ma-loco/BasicSAMDArduino/BasicCustomBoard-Hardware/BasicCustomBoardExample.jpg

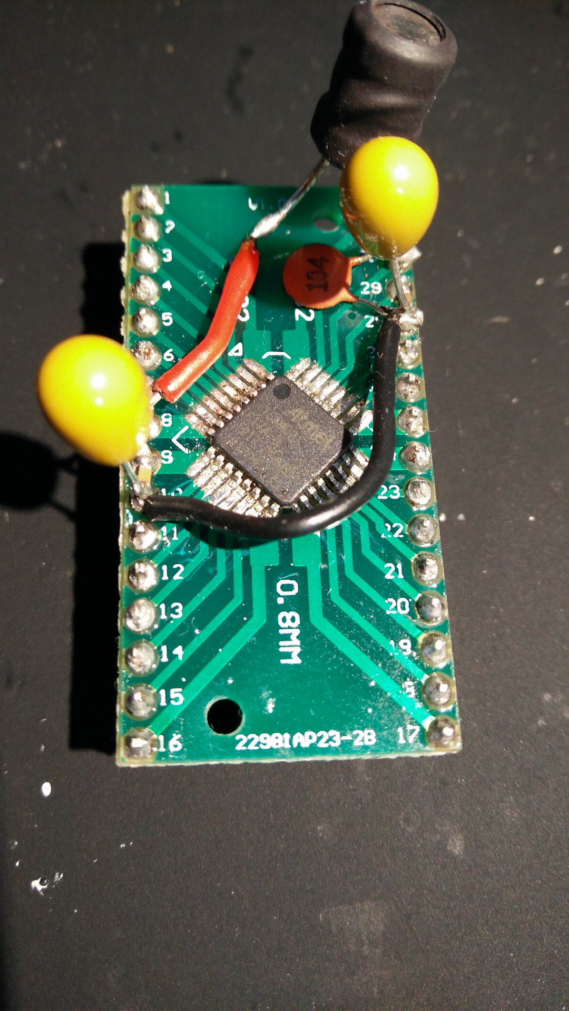
BasicCustomBoard-Hardware/BasicCustomBoardExample.jpg
