ma-loco/BasicSAMDArduino/BasicCustomBoard-Hardware/BasicCustomBoard.kicad_pcb

## KiCad design Report/electricals/electricals.sch


Parts:
ForceSensor: R
R3.3K: R
SW: SW_Push

Connections:
+5V: ForceSensor.1, SW.1
Earth: R3.3K.2
unnamed: ForceSensor.2, R3.3K.1

Notes on the sheet:
Force Sensor Circuit
Button Circuit
Arduino Direction
Arduino PWM
Arduino Button Read
Arduino Force Sensor Read
Motor Circuit
