ma-loco/BasicSAMDArduino/variants/generic_samd21e16b/variant.h

/*
  Copyright (c) 2014-2015 Arduino LLC.  All right reserved.

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
  You should have received a copy of the GNU Lesser General Public
  License along with this library; if not, write to the Free Software
  Foundation, Inc., 51 Franklin St, Fifth Floor, Boston, MA  02110-1301  USA
*/

#ifndef _VARIANT_SAMD21E16B_
#define _VARIANT_SAMD21E16B_

// The definitions here needs a SAMD core >=1.6.6
#define ARDUINO_SAMD_VARIANT_COMPLIANCE 10606

/*----------------------------------------------------------------------------
 *        Definitions
 *----------------------------------------------------------------------------*/

/** Frequency of the board main oscillator */
#define VARIANT_MAINOSC	(32768ul)

/** Master clock frequency */
#define VARIANT_MCK	(F_CPU)

/*----------------------------------------------------------------------------
 *        Headers
 *----------------------------------------------------------------------------*/

#include "WVariant.h"

#ifdef __cplusplus
#include "SERCOM.h"
#include "Uart.h"
#endif // __cplusplus

#ifdef __cplusplus
extern "C"
{
#endif // __cplusplus

/*----------------------------------------------------------------------------
 *        Pins
 *----------------------------------------------------------------------------*/

// Number of pins defined in PinDescription array
extern unsigned int PINCOUNT_fn();

#define PINS_COUNT           (PINCOUNT_fn())
#define NUM_DIGITAL_PINS     (17u)
#define NUM_ANALOG_INPUTS    (4u)
#define NUM_ANALOG_OUTPUTS   (1u)
#define analogInputToDigitalPin(p)  ((p < NUM_ANALOG_INPUTS) ? (p) + PIN_A0 : -1)

#define digitalPinToPort(P)        ( &(PORT->Group[g_APinDescription[P].ulPort]) )
#define digitalPinToBitMask(P)     ( 1 << g_APinDescription[P].ulPin )
//#define analogInPinToBit(P)        ( )
#define portOutputRegister(port)   ( &(port->OUT.reg) )
#define portInputRegister(port)    ( &(port->IN.reg) )
#define portModeRegister(port)     ( &(port->DIR.reg) )
#define digitalPinHasPWM(P)        ( g_APinDescription[P].ulPWMChannel != NOT_ON_PWM || g_APinDescription[P].ulTCChannel != NOT_ON_TIMER )

/*
 * digitalPinToTimer(..) is AVR-specific and is not defined for SAMD
 * architecture. If you need to check if a pin supports PWM you must
 * use digitalPinHasPWM(..).
 *
 * https://github.com/arduino/Arduino/issues/1833
 */
// #define digitalPinToTimer(P)

// LEDs
#define PIN_LED_12           (12u)
#define PIN_LED              PIN_LED_12
#define LED_BUILTIN          PIN_LED_12

/*
 * Analog pins
 */
#define PIN_A0               (8ul)
#define PIN_A1               (9ul)
#define PIN_A2               (10ul)
#define PIN_A3               (11ul)
#define PIN_DAC0             (26ul)

static const uint8_t A0  = PIN_A0;
static const uint8_t A1  = PIN_A1;
static const uint8_t A2  = PIN_A2;
static const uint8_t A3  = PIN_A3;
static const uint8_t DAC0 = PIN_DAC0;

#define ADC_RESOLUTION		12

/*
 * Serial interfaces
 */

// Serial (sercom 3)
#define PIN_SERIAL_RX       (1ul) /* PA23 */
#define PAD_SERIAL_RX       (SERCOM_RX_PAD_1)
#define PIN_SERIAL_TX       (0ul) /* PA22 */
#define PAD_SERIAL_TX       (UART_TX_PAD_0)

/*
 * SPI Interfaces
 */
#define SPI_INTERFACES_COUNT 1

#define PIN_SPI_SS          (14ul)  /* PA17, SERCOM1/PAD[1] */
#define PIN_SPI_MISO        (13ul)  /* PA16, SERCOM1/PAD[0] */
#define PIN_SPI_MOSI        (15ul) /* PA18, SERCOM1/PAD[2] */
#define PIN_SPI_SCK         (16ul) /* PA19, SERCOM1/PAD[3] */
#define PERIPH_SPI          sercom1
#define PAD_SPI_TX          SPI_PAD_2_SCK_3
#define PAD_SPI_RX          SERCOM_RX_PAD_0

static const uint8_t SS	  = PIN_SPI_SS ; // Hardware SS not used in Master mode but we reserve and configure it for use in Server mode.
static const uint8_t MOSI = PIN_SPI_MOSI ;
static const uint8_t MISO = PIN_SPI_MISO ;
static const uint8_t SCK  = PIN_SPI_SCK ;

/*
 * Wire Interfaces
 */
#define WIRE_INTERFACES_COUNT 1

#define PIN_WIRE_SDA         (20u)
#define PIN_WIRE_SCL         (21u)
#define PERIPH_WIRE          sercom0
#define WIRE_IT_HANDLER      SERCOM0_Handler

static const uint8_t SDA = PIN_WIRE_SDA;
static const uint8_t SCL = PIN_WIRE_SCL;

/*
 * USB
 */
#define PIN_USB_HOST_ENABLE (17ul)
#define PIN_USB_DM          (18ul)
#define PIN_USB_DP          (19ul)

#ifdef __cplusplus
}
#endif

/*----------------------------------------------------------------------------
 *        Arduino objects - C++ only
 *----------------------------------------------------------------------------*/

#ifdef __cplusplus

/*	=========================
 *	===== SERCOM DEFINITION
 *	=========================
*/
extern SERCOM sercom0;
extern SERCOM sercom1;
extern SERCOM sercom2;
extern SERCOM sercom3;

extern Uart Serial;

#endif

// These serial port names are intended to allow libraries and architecture-neutral
// sketches to automatically default to the correct port name for a particular type
// of use.  For example, a GPS module would normally connect to SERIAL_PORT_HARDWARE_OPEN,
// the first hardware serial port whose RX/TX pins are not dedicated to another use.
//
// SERIAL_PORT_MONITOR        Port which normally prints to the Arduino Serial Monitor
//
// SERIAL_PORT_USBVIRTUAL     Port which is USB virtual serial
//
// SERIAL_PORT_LINUXBRIDGE    Port which connects to a Linux system via Bridge library
//
// SERIAL_PORT_HARDWARE       Hardware serial port, physical RX & TX pins.
//
// SERIAL_PORT_HARDWARE_OPEN  Hardware serial ports which are open for use.  Their RX & TX
//                            pins are NOT connected to anything by default.

#define SERIAL_PORT_USBVIRTUAL      Serial
#define SERIAL_PORT_MONITOR         Serial
// Serial has no physical pins broken out, so it's not listed as HARDWARE port
#define SERIAL_PORT_HARDWARE        Serial
#define SERIAL_PORT_HARDWARE_OPEN   Serial

#endif /* _VARIANT_SAMD21E17A_ */
