ma-loco/BasicSAMDArduino/variants/generic_samd21e16b/variant.cpp

/*
  Copyright (c) 2014-2015 Arduino LLC.  All right reserved.

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
  You should have received a copy of the GNU Lesser General Public
  License along with this library; if not, write to the Free Software
  Foundation, Inc., 51 Franklin St, Fifth Floor, Boston, MA  02110-1301  USA
*/


#include "variant.h"

/*
 * Pins descriptions
 */
const PinDescription g_APinDescription[]=
{
  // UART
  // GPIO 0 - SERCOM3 for UART TX and general purpose pin
  { PORTA, 22, PIO_SERCOM, PIN_ATTR_DIGITAL, No_ADC_Channel, NOT_ON_PWM, NOT_ON_TIMER, EXTERNAL_INT_6 }, // SERCOM[3]/PAD[0]
  // GPIO 1 - SERCOM3 for UART RX and general purpose pin
  { PORTA, 23, PIO_SERCOM, PIN_ATTR_DIGITAL, No_ADC_Channel, NOT_ON_PWM, NOT_ON_TIMER, EXTERNAL_INT_7 }, // SERCOM[3]/PAD[1]

  // GPIO 2 to 5 - Digital pins with PWM and Timer, analog capable
  { PORTA,  4, PIO_TIMER, (PIN_ATTR_DIGITAL|PIN_ATTR_PWM|PIN_ATTR_TIMER), ADC_Channel4, PWM0_CH0, TCC0_CH0, EXTERNAL_INT_4 }, // ADC/AIN[4]; TCC0/WO[0]
  { PORTA,  5, PIO_TIMER, (PIN_ATTR_DIGITAL|PIN_ATTR_PWM|PIN_ATTR_TIMER), ADC_Channel5, PWM0_CH1, TCC0_CH1, EXTERNAL_INT_5 }, // ADC/AIN[5]; TCC0/WO[1]
  { PORTA,  6, PIO_TIMER, (PIN_ATTR_DIGITAL|PIN_ATTR_PWM|PIN_ATTR_TIMER), ADC_Channel6, PWM1_CH0, TCC1_CH0, EXTERNAL_INT_6 }, // ADC/AIN[6]; TCC1/WO[0]
  { PORTA,  7, PIO_TIMER, (PIN_ATTR_DIGITAL|PIN_ATTR_PWM|PIN_ATTR_TIMER), ADC_Channel7, PWM1_CH1, TCC1_CH1, EXTERNAL_INT_7 }, // ADC/AIN[6]; TCC1/WO[1]
   
  // GPIO 6 & 7 - Digital pins with PWM and Timer
  { PORTA, 14, PIO_TIMER, (PIN_ATTR_DIGITAL|PIN_ATTR_PWM|PIN_ATTR_TIMER), No_ADC_Channel, PWM3_CH0, TC3_CH0, EXTERNAL_INT_14 }, // TC3/WO[0]
  { PORTA, 15, PIO_TIMER, (PIN_ATTR_DIGITAL|PIN_ATTR_PWM|PIN_ATTR_TIMER), No_ADC_Channel, PWM3_CH1, TC3_CH1, EXTERNAL_INT_15 }, // TC3/WO[1]

  // GPIO 8 - 11 - Analog pins
  // -------------------------
  { PORTA,  2, PIO_ANALOG, PIN_ATTR_ANALOG, ADC_Channel0, NOT_ON_PWM, NOT_ON_TIMER, EXTERNAL_INT_2 }, // ADC/AIN[0]
  { PORTA,  3, PIO_ANALOG, PIN_ATTR_ANALOG, ADC_Channel1, NOT_ON_PWM, NOT_ON_TIMER, EXTERNAL_INT_3 }, // ADC/AIN[1]; ADC VREFA/DAC VREFA
  { PORTA, 10, PIO_ANALOG, (PIN_ATTR_ANALOG|PIN_ATTR_PWM|PIN_ATTR_TIMER), ADC_Channel18, PWM1_CH0, TCC1_CH0, EXTERNAL_INT_10 }, // ADC/AIN[18]; TCC1/WO[0]
  { PORTA, 11, PIO_ANALOG, (PIN_ATTR_ANALOG|PIN_ATTR_PWM|PIN_ATTR_TIMER), ADC_Channel19, PWM1_CH1, TCC1_CH1, EXTERNAL_INT_11 }, // ADC/AIN[19]; TCC1/WO[1]

  // GPIO 12 (LED)
  { PORTA, 27, PIO_DIGITAL, PIN_ATTR_DIGITAL, No_ADC_Channel, NOT_ON_PWM, NOT_ON_TIMER, EXTERNAL_INT_15 },

  // GPIO 13 - 16 (SPI on SERCOM1, including Hardware SS for Server mode)
  // --------------------------------------------------------------------
  { PORTA, 16, PIO_SERCOM, PIN_ATTR_DIGITAL, No_ADC_Channel, NOT_ON_PWM, NOT_ON_TIMER, EXTERNAL_INT_0 }, // SERCOM[1]/PAD[0]
  { PORTA, 17, PIO_SERCOM, PIN_ATTR_DIGITAL, No_ADC_Channel, NOT_ON_PWM, NOT_ON_TIMER, EXTERNAL_INT_1 }, // SERCOM[1]/PAD[1]
  { PORTA, 18, PIO_SERCOM, PIN_ATTR_DIGITAL, No_ADC_Channel, NOT_ON_PWM, NOT_ON_TIMER, EXTERNAL_INT_2 }, // SERCOM[1]/PAD[2]
  { PORTA, 19, PIO_SERCOM, PIN_ATTR_DIGITAL, No_ADC_Channel, NOT_ON_PWM, NOT_ON_TIMER, EXTERNAL_INT_3 }, // SERCOM[1]/PAD[3]

  // GPIO 17, 18, 19 (USB interface) - Future, not in adaptor board yet
  // ------------------------------------------------------------------
  { PORTA, 28, PIO_COM, PIN_ATTR_NONE, No_ADC_Channel, NOT_ON_PWM, NOT_ON_TIMER, EXTERNAL_INT_NONE }, // USB Host enable
  { PORTA, 24, PIO_COM, PIN_ATTR_NONE, No_ADC_Channel, NOT_ON_PWM, NOT_ON_TIMER, EXTERNAL_INT_NONE }, // USB/DM
  { PORTA, 25, PIO_COM, PIN_ATTR_NONE, No_ADC_Channel, NOT_ON_PWM, NOT_ON_TIMER, EXTERNAL_INT_NONE }, // USB/DP

  // GPIO 20 & 21 - (I2C/Wire on SERCOM0)
  // ------------------------------------
  { PORTA,  8, PIO_SERCOM, PIN_ATTR_DIGITAL, No_ADC_Channel, NOT_ON_PWM, NOT_ON_TIMER, EXTERNAL_INT_NMI }, // SERCOM[0]/PAD[0]
  { PORTA,  9, PIO_SERCOM, PIN_ATTR_DIGITAL, No_ADC_Channel, NOT_ON_PWM, NOT_ON_TIMER, EXTERNAL_INT_9 }, // SERCOM[0]/PAD[1]

  // GPIO 22 & 23 - Oscilator pins, reserved
  { PORTA,  0, PIO_DIGITAL, PIN_ATTR_NONE, No_ADC_Channel, NOT_ON_PWM, NOT_ON_TIMER, EXTERNAL_INT_NONE }, 
  { PORTA,  1, PIO_DIGITAL, PIN_ATTR_NONE, No_ADC_Channel, NOT_ON_PWM, NOT_ON_TIMER, EXTERNAL_INT_NONE }, 

  // GPIO 24 & 25 - SWCLK & SWDIO
  { PORTA, 30, PIO_COM, PIN_ATTR_NONE, No_ADC_Channel, NOT_ON_PWM, NOT_ON_TIMER, EXTERNAL_INT_NONE },
  { PORTA, 31, PIO_COM, PIN_ATTR_NONE, No_ADC_Channel, NOT_ON_PWM, NOT_ON_TIMER, EXTERNAL_INT_NONE },

  // GPIO 26 - Alternate use pin as DAC output
  { PORTA,  2, PIO_ANALOG, PIN_ATTR_ANALOG, DAC_Channel0, NOT_ON_PWM, NOT_ON_TIMER, EXTERNAL_INT_NONE }, // DAC/VOUT
} ;

const void* g_apTCInstances[TCC_INST_NUM+TC_INST_NUM]={ TCC0, TCC1, TCC2, TC3, TC4, TC5 } ;

extern "C" {
    unsigned int PINCOUNT_fn() {
        return (sizeof(g_APinDescription) / sizeof(g_APinDescription[0]));
    }
}

// Multi-serial objects instantiation
SERCOM sercom0( SERCOM0 ) ;
SERCOM sercom1( SERCOM1 ) ;
SERCOM sercom2( SERCOM2 ) ;
SERCOM sercom3( SERCOM3 ) ;

Uart Serial( &sercom3, PIN_SERIAL_RX, PIN_SERIAL_TX, PAD_SERIAL_RX, PAD_SERIAL_TX ) ;

void SERCOM3_Handler()
{
  Serial.IrqHandler();
}
