ma-loco/BasicSAMDArduino/(commit log)

2021-07-14 Added existing project to source control
    [samd21e15.cfg, samd21e17.cfg]
2021-07-21 Added schematic and implementation example for the HW
    [BasicCustomBoard.kicad_pcb, BasicCustomBoard.sch]
2021-08-22 Added Arduino pins diagram
2021-09-01 Made board color friendlier for B&W printing.
2021-09-01 Now ignores runtime kicad file.
2021-09-01 Added support for the samd21e16b chip.
    [samd21e16.cfg]
2021-10-31 Added a pull.up resistor on SWCLK as recommended by uC maker.
    [BasicCustomBoard.sch]
